blagojenikolic91/ESP32S2_DevBoard/ESP32-S2DevBoard.kicad_pcb

## KiCad design ESP32-S2DevBoard.kicad_pcb (2023-02-09)

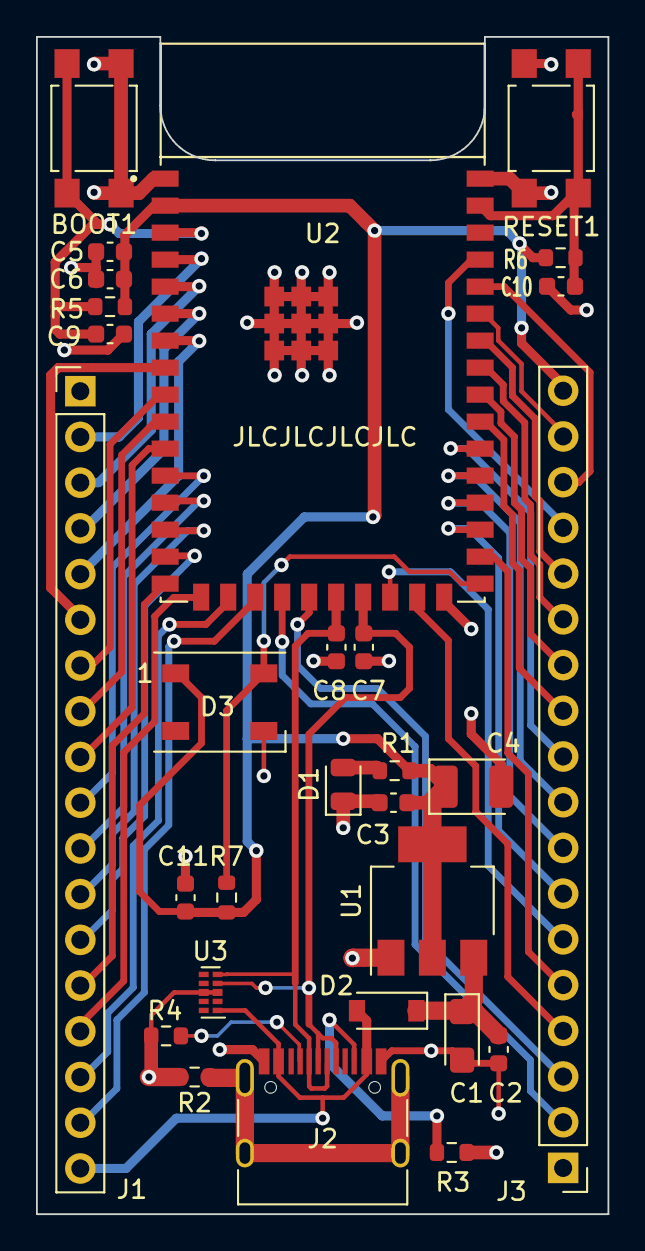
[picture p3: board ESP32-S2DevBoard.kicad_pcb from above]

Board: 2 copper layers, 31.8 x 65.4 mm, 29 parts (0 on the bottom side), 45 nets.

Parts:
BOOT1: SW_SPST; SW_SPST_TL3305B
C1: 10uF; CP_EIA-3216-18_Kemet-A
C2, C3, C5: 100nF; C_0603_1608Metric
C4: 22uF; CP_EIA-3528-15_AVX-H
C6, C11: 10uF; C_0603_1608Metric
C7, C8: 22pF; C_0603_1608Metric
C9, C10: 1uF; C_0603_1608Metric
D1: Red LED; LED_0805_2012Metric
D2: D_Schottky; D_SOD-123
D3: WS2812B; LED_WS2812B_PLCC4_5.0x5.0mm_P3.2mm
J1, J3: Conn_01x18; PinHeader_1x18_P2.54mm_Vertical
J2: USB_C_Receptacle_USB2.0; USB_C_Receptacle_HRO_TYPE-C-31-M-12
R1, R3, R4: 5k1; R_0603_1608Metric
R2: 1M; R_0603_1608Metric
R5, R6, R7: 10k; R_0603_1608Metric
RESET1: SW_SPST; SW_SPST_TL3305B
U1: AMS1117-3.3; SOT-223-3_TabPin2
U2: ESP32-S2-WROOM; XCVR_ESP32-S2-WROOM
U3: TPD4E02B04DQA; USON-10_2.5x1.0mm_P0.5mm

Connections:
+3V3: C3.1, C4.1, C5.1, C6.1, C11.1, D3.1 (VDD), J3.18, R1.1, R5.1, R6.1, R7.1, U1.2 (VO), U2.2 (3V3)
+5V: D2.2 (A), J1.18, J2.A4 (VBUS), J2.A9 (VBUS), J2.B4 (VBUS), J2.B9 (VBUS), U3.1 (IO1)
Data+: C7.1, J2.A6 (D+), J2.B6 (D+), U2.23 (IO20), U3.4 (IO3)
Data-: C8.1, J2.A7 (D-), J2.B7 (D-), U2.22 (IO19), U3.5 (IO4)
Enable: C10.1, R6.2, RESET1.1 (A), U2.41 (EN)
GND: BOOT1.2 (B), C1.2, C2.2, C3.2, C4.2, C5.2, C6.2, C7.2, C8.2, C9.2, C10.2, C11.2, D1.1 (K), D3.3 (VSS), J1.1, J2.A1 (GND), J2.A12 (GND), J2.B1 (GND), J2.B12 (GND), J3.1, R2.2, R3.2, R4.2, RESET1.2 (B), U1.1 (GND), U2.1 (GND), U2.26 (GND), U2.42 (GND), U2.43 (GND), U2.44 (GND), U2.45 (GND), U2.46 (GND), U2.47 (GND), U2.48 (GND), U2.49 (GND), U2.50 (GND), U2.51 (GND), U3.3 (G), U3.8 (G)
GPIO0: BOOT1.1 (A), C9.1, R5.2, U2.3 (IO0)
GPIO1: J1.2, U2.4 (IO1)
GPIO2: J1.3, U2.5 (IO2)
GPIO3: J1.4, U2.6 (IO3)
GPIO4: J1.5, U2.7 (IO4)
GPIO5: J1.6, U2.8 (IO5)
GPIO6: J1.7, U2.9 (IO6)
GPIO7: J1.8, U2.10 (IO7)
GPIO8: J1.9, U2.11 (IO8)
GPIO9: J1.10, U2.12 (IO9)
GPIO10: J1.11, U2.13 (IO10)
GPIO11: J1.12, U2.14 (IO11)
GPIO12: J1.13, U2.15 (IO12)
GPIO13: J1.14, U2.16 (IO13)
GPIO14: J1.15, U2.17 (IO14)
GPIO15: J1.16, U2.18 (IO15)
GPIO16: J1.17, U2.19 (IO16)
GPIO17: J3.2, U2.20 (IO17)
GPIO18: J3.3, U2.21 (IO18)
GPIO21: J3.6, U2.24 (IO21)
GPIO26: J3.4, U2.25 (IO26)
GPIO34: J3.5, U2.28 (IO34)
GPIO35: J3.7, U2.29 (IO35)
GPIO36: J3.8, U2.30 (IO36)
GPIO37: J3.9, U2.31 (IO37)
GPIO38: J3.10, U2.32 (IO38)
GPIO39: J3.11, U2.33 (IO39)
GPIO40: J3.12, U2.34 (IO40)
GPIO41: J3.13, U2.35 (IO41)
GPIO42: J3.14, U2.36 (IO42)
GPIO45: J3.15, U2.39 (IO45)
unnamed: C1.1, C2.1, D2.1 (K), U1.3 (VI)
unnamed: D1.2 (A), R1.2
unnamed: J2.A5 (CC1), R4.1
unnamed: J2.B5 (CC2), R3.1
unnamed: J2.S1 (SHIELD), R2.1
RXDO: J3.16, U2.38 (RXD0)
StsLED: D3.4 (DIN), R7.2, U2.27 (IO33)
TXD0: J3.17, U2.37 (TXD0)
